MiguelRochaBE/Biosignal-Instrumentation/EEG/RLD.png

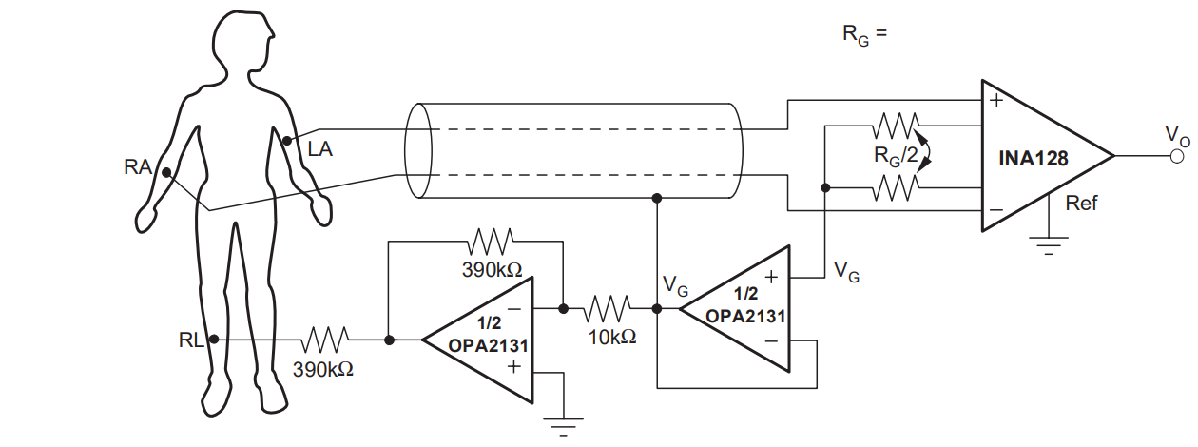
EEG/RLD.png
