MiguelRochaBE/Biosignal-Instrumentation/(list of files, drawings)

Other design files:
ECG/AbsoluteValueCconverter.ms14
ECG/Band-pass_filter.ms14
ECG/ECG.ms14
ECG/FullCircuit.ms14
ECG/High-pass_filter.ms14
ECG/Instrumentation_Amplifier.ms14
ECG/Low-pass_filter2.ms14
ECG/Low-pass_filter.ms14
ECG/notc.ms14
ECG/Notch_filter.ms14
EEG/fullcircuit_EEG.ms14
EEG/real_fullcircuit.ms14
